ejackson1/Mobile-Manipulator/mobile-base/docs/robopads.gif

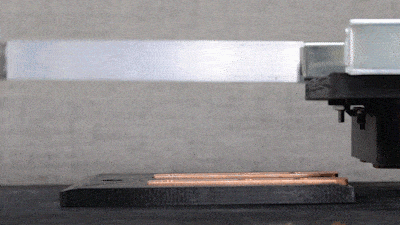
mobile-base/docs/robopads.gif
