ejackson1/Mobile-Manipulator/mobile-base/mobile_base_control/urdf/right_hand_system_assembled.stl

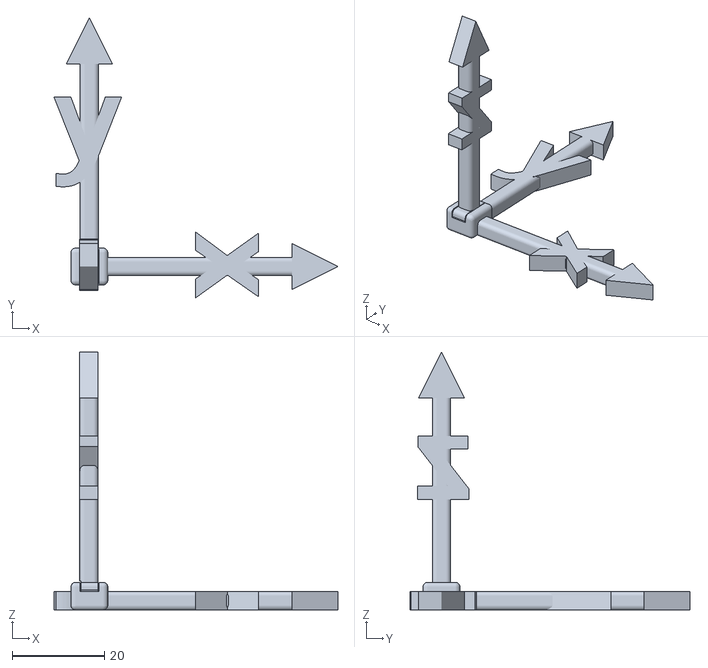
[picture p9: CAD file, 2023-06-07]
mobile-base/mobile_base_control/urdf/right_hand_system_assembled.stl
61.7 x 60.9 x 56.0
