ejackson1/Mobile-Manipulator/mobile-base/mobile_base_description/meshes/WPI_Mecanum_Wheel_fixed_origin.stl

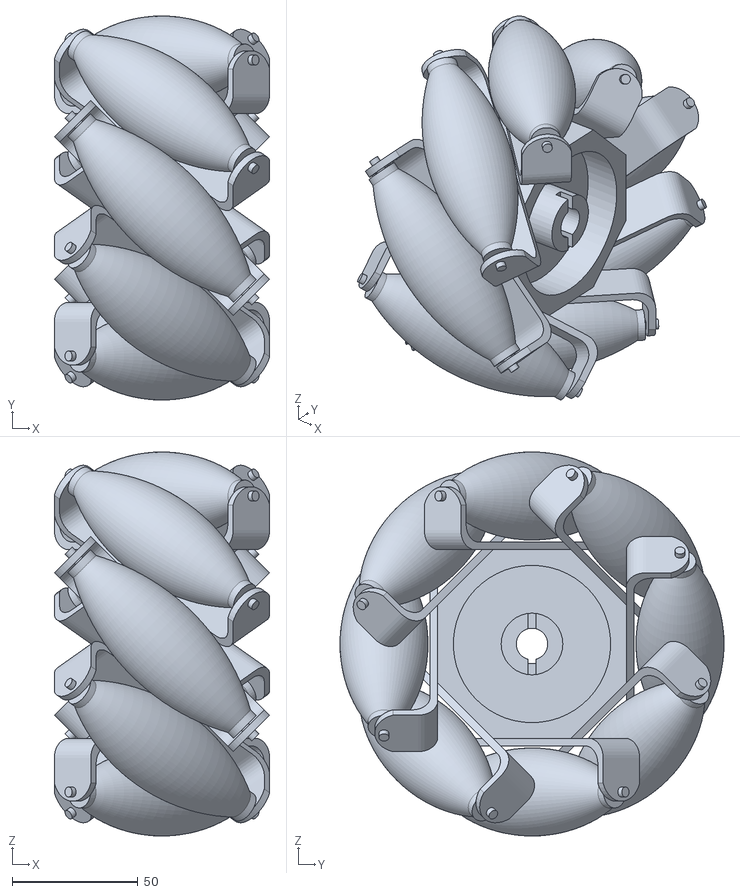
[picture p10: CAD file, 2023-06-07]
mobile-base/mobile_base_description/meshes/WPI_Mecanum_Wheel_fixed_origin.stl
85.6 x 152.6 x 152.6
