ejackson1/Mobile-Manipulator/mobile-base/panda_arm/franka_description/meshes/collision/link4.stl

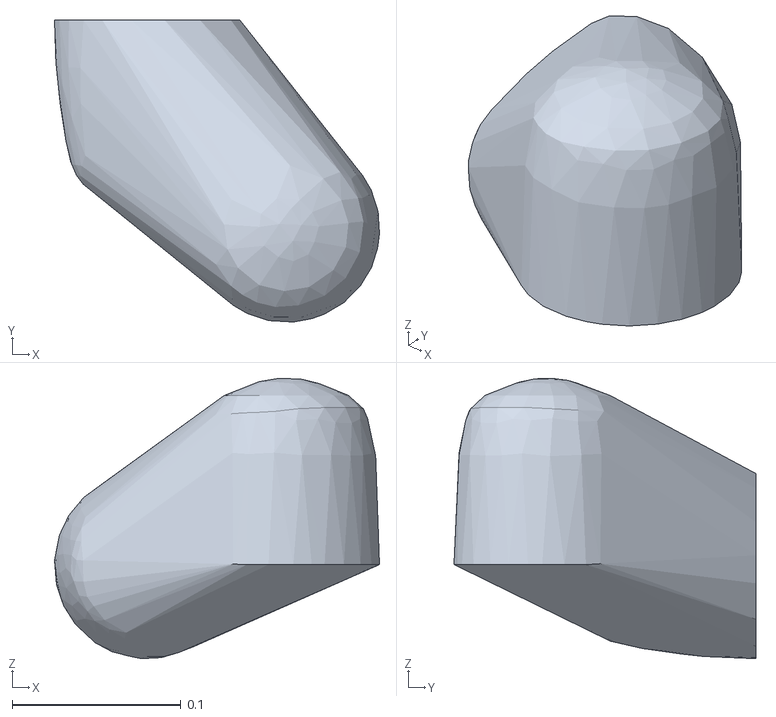
[picture p11: CAD file, 2023-01-15]
mobile-base/panda_arm/franka_description/meshes/collision/link4.stl
0.193 x 0.179 x 0.166
