ejackson1/Mobile-Manipulator/mobile-base/panda_arm/franka_description/meshes/collision/link5.stl

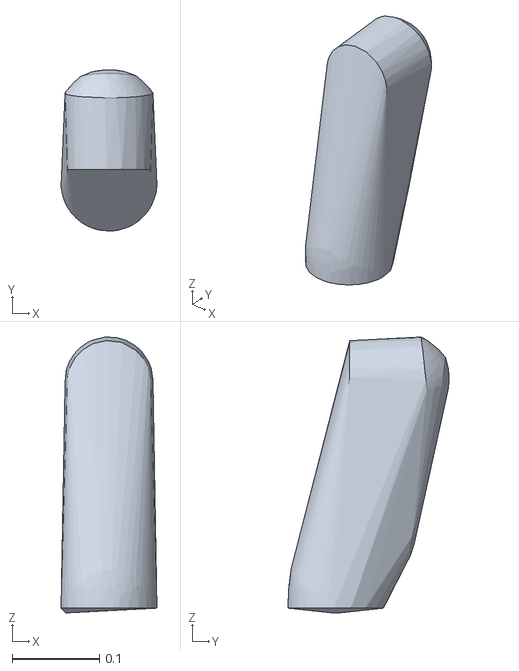
[picture p12: CAD file, 2023-01-15]
mobile-base/panda_arm/franka_description/meshes/collision/link5.stl
0.11 x 0.185 x 0.317
