ejackson1/Mobile-Manipulator/mobile-base/panda_arm/franka_description/meshes/collision/hand.stl

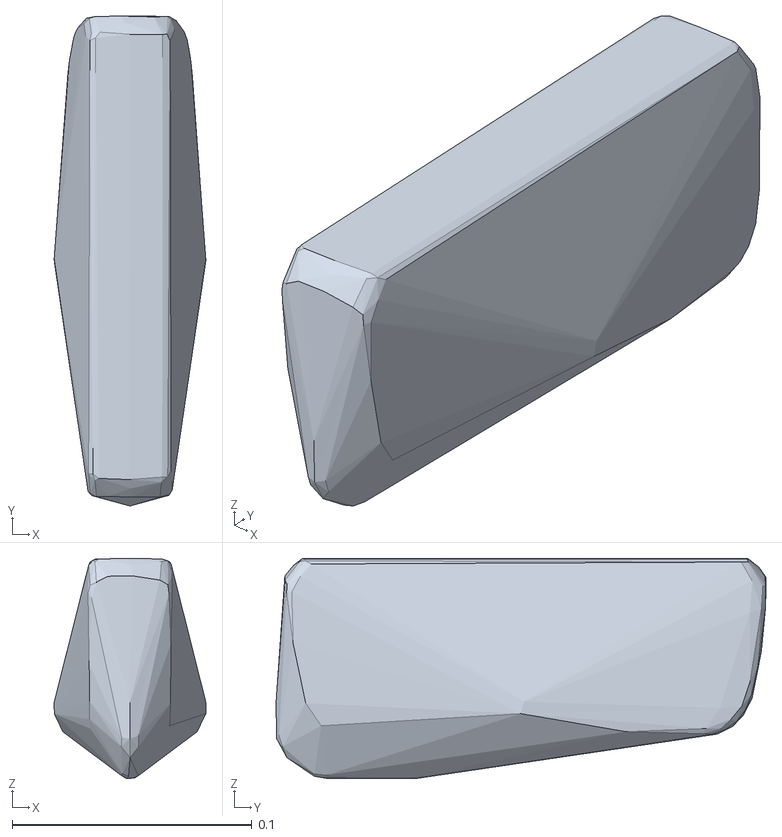
[picture p14: CAD file, 2023-01-15]
mobile-base/panda_arm/franka_description/meshes/collision/hand.stl
0.0633 x 0.204 x 0.0919
