ejackson1/Mobile-Manipulator/mobile-base/panda_arm/franka_description/meshes/collision/finger.stl

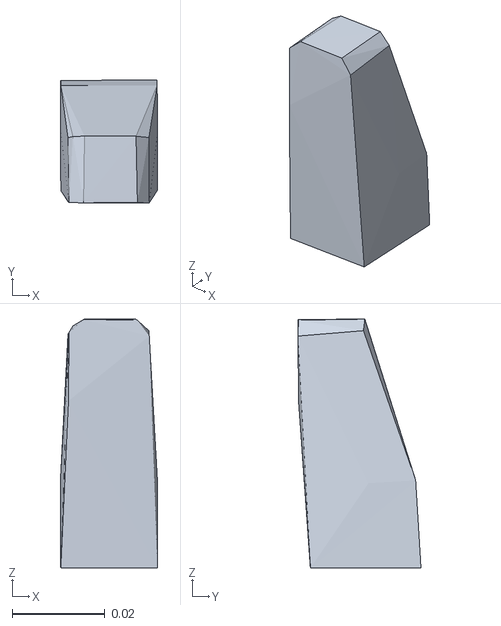
[picture p15: CAD file, 2023-01-15]
mobile-base/panda_arm/franka_description/meshes/collision/finger.stl
0.021 x 0.0265 x 0.0537
