ejackson1/Mobile-Manipulator/mobile-base/panda_arm/franka_description/meshes/collision/link3.stl

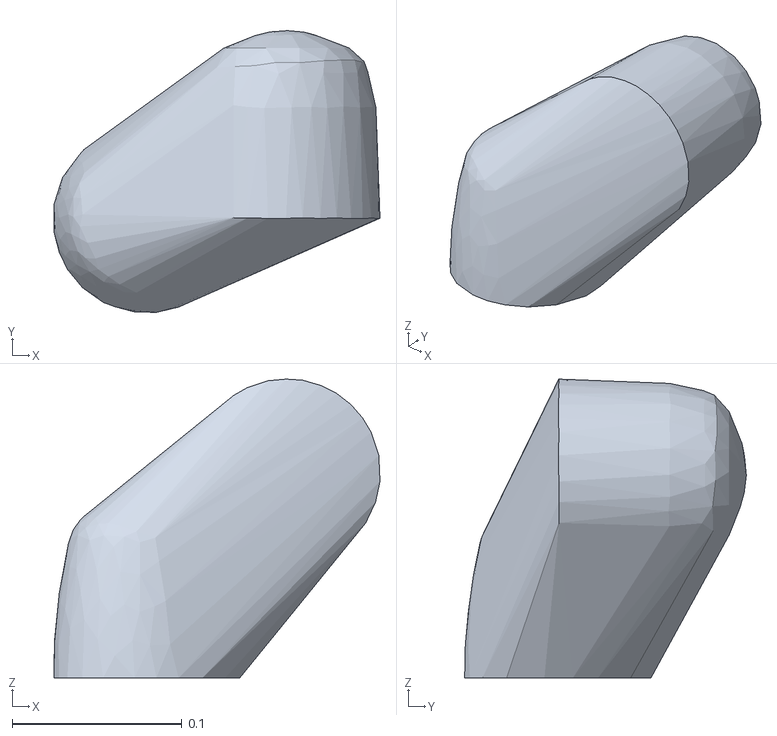
[picture p16: CAD file, 2023-01-15]
mobile-base/panda_arm/franka_description/meshes/collision/link3.stl
0.192 x 0.166 x 0.176
