ejackson1/Mobile-Manipulator/mobile-base/panda_arm/franka_description/meshes/collision/link6.stl

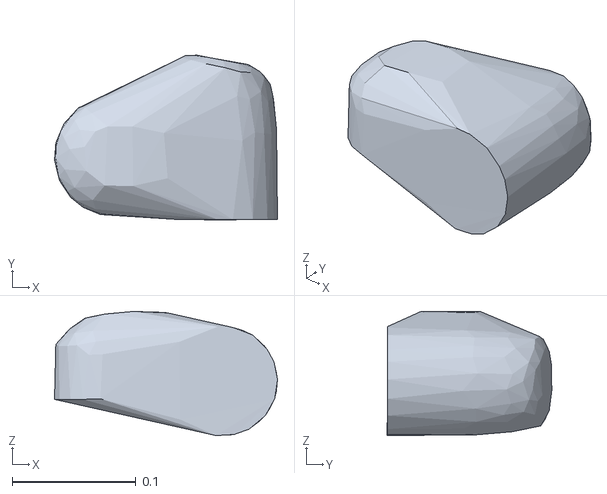
[picture p17: CAD file, 2023-01-15]
mobile-base/panda_arm/franka_description/meshes/collision/link6.stl
0.18 x 0.133 x 0.1
