ejackson1/Mobile-Manipulator/mobile-base/panda_arm/franka_description/meshes/collision/link7.stl

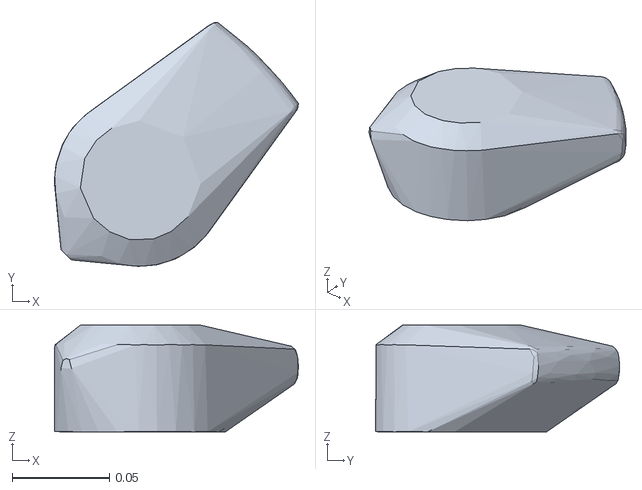
[picture p18: CAD file, 2023-01-15]
mobile-base/panda_arm/franka_description/meshes/collision/link7.stl
0.125 x 0.125 x 0.0548
