ejackson1/Mobile-Manipulator/mobile-base/panda_arm/franka_description/meshes/collision/link0.stl

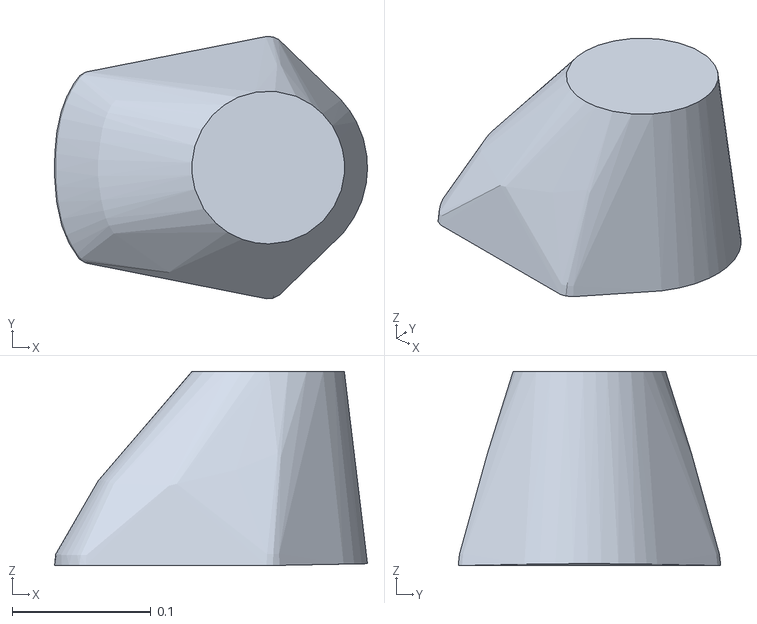
[picture p19: CAD file, 2023-01-15]
mobile-base/panda_arm/franka_description/meshes/collision/link0.stl
0.226 x 0.189 x 0.14
