ejackson1/Mobile-Manipulator/(list of files, cad)

Other CAD files:
mobile-base/mobile_base_description/meshes/Chassis_with_Suspension_fixed_origin.stl
mobile-base/mobile_base_description/meshes/MI_with_TableTop_fixed_origin.stl
mobile-base/mobile_base_description/meshes/mecanum_wheel.STL
mobile-base/panda_arm/franka_description/meshes/collision/link2.stl
