ejackson1/Mobile-Manipulator/mobile-base/build/install_manifest.txt

/usr/local/lib/libsick_scan_shared_lib.so
/usr/local/include/sick_scan_api.h
/usr/local/include/sick_scan_api.py
