ejackson1/Mobile-Manipulator/(commit log)

2023-01-16 Working IK and FW of mecanum wheels, implemented teleop
2023-02-04 too much work
    [WPI_Mecanum_Wheel_fixed_origin.stl, model.xacro, panda_arm.xacro, panda_insert.xacro, wheel.xacro]
2023-02-14 fine tuning control variables
    [right_hand_system_assembled.stl, right_hand_system_assembled.xacro]
2023-04-21 Readjusted parallel linkage in Panda_description and Xacro files, adding in advanced position joint limits
    [model.xacro, panda_insert.xacro]
2023-06-07 attempting merge
    [WPI_Mecanum_Wheel_fixed_origin.stl, model.xacro, panda_arm.xacro, panda_insert.xacro, right_hand_system_assembled.stl, right_hand_system_assembled.xacro, wheel.xacro]
